GLOXIOU/Handbrake-DIY/BOM.csv

Component | Price
ESP-32 S3 | 8.93$
WH148 15mm 10K | 3.86$
Springs | 7.08$
Total | 19.87$
