GLOXIOU/Handbrake-DIY/3D-files/to print/Cover.stl

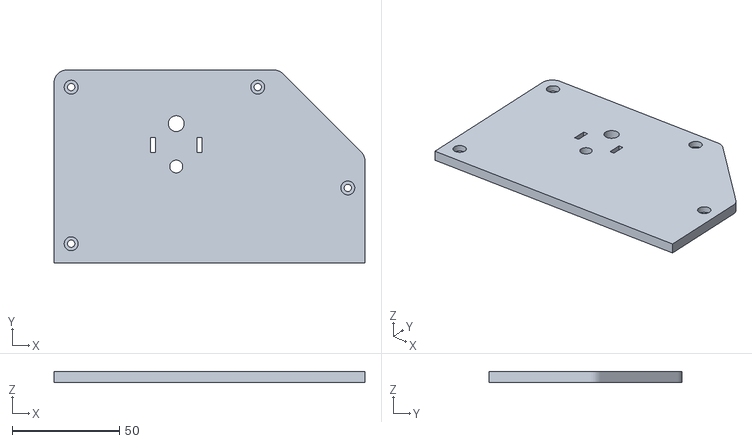
[picture p5: CAD file, 2026-10-22]
3D-files/to print/Cover.stl
145.0 x 90.0 x 5.00
