GLOXIOU/Handbrake-DIY/3D-files/to print/Lever.stl

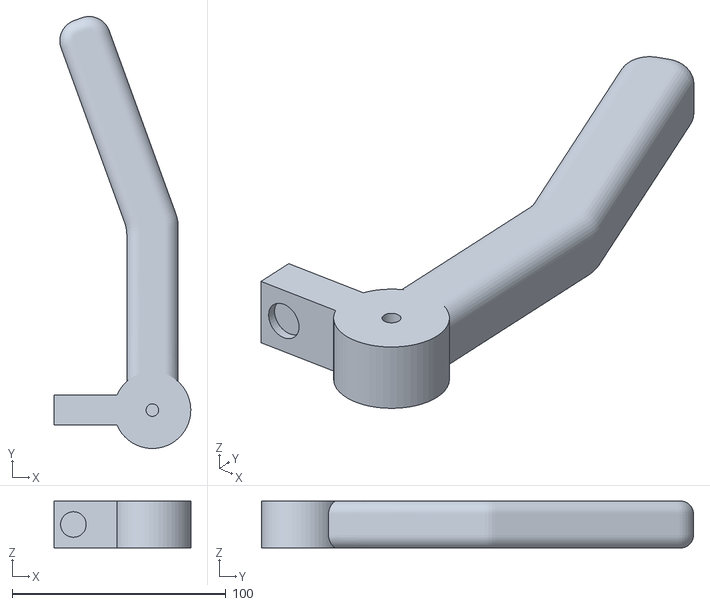
[picture p7: CAD file, 2026-10-22]
3D-files/to print/Lever.stl
64.0 x 202.3 x 22.0
