GLOXIOU/Handbrake-DIY/3D-files/to print/Case.stl

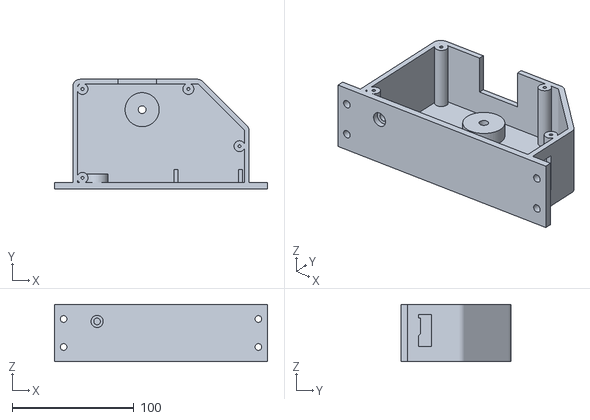
[picture p8: CAD file, 2026-10-22]
3D-files/to print/Case.stl
175.0 x 90.0 x 47.0
