GLOXIOU/Handbrake-DIY/3D-files/to print/PotCap.stl

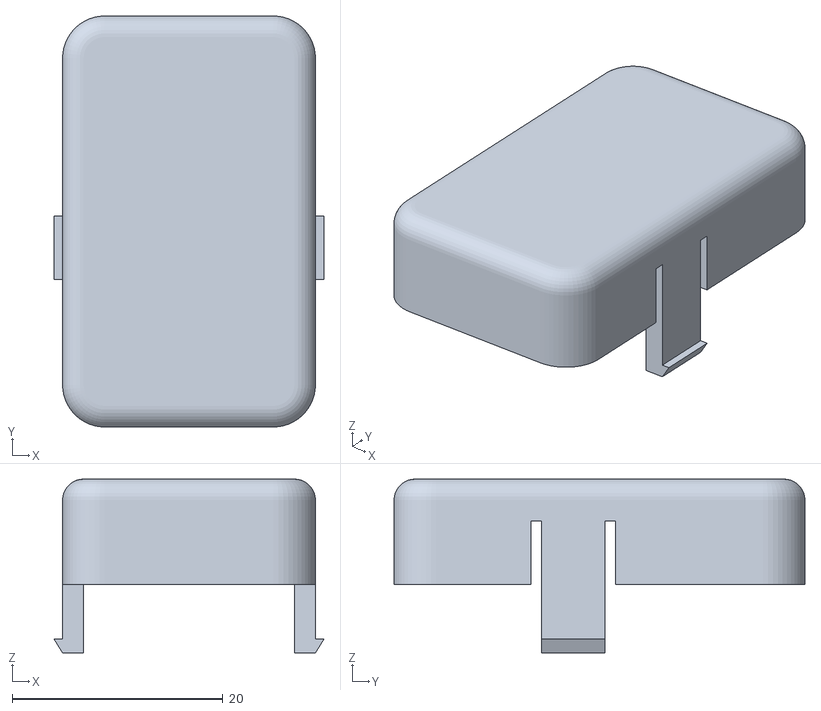
[picture p9: CAD file, 2026-10-22]
3D-files/to print/PotCap.stl
25.6 x 39.0 x 16.5
