GLOXIOU/Handbrake-DIY/(list of files, cad)

Other CAD files:
3D-files/Handbrake-DIY.f3d
