GLOXIOU/Handbrake-DIY/JOURNAL.md

| title | Handbrake-DIY |
| --- | --- |
| author | GLOXIOU |
| description | A DIY project for a simeracing handbrake, print in 3D and controlled by a ESP32.
| created_at | 2026-10-18 |

# Day 1: Defining system & idea search & inspiration

I want to make a simeracing handbrake, print in 3D, and controlled by a ESP32. The handbrake will have a litlle support so I can hang it up to my current support for my wheele. And the 3D part need to be bellow 256mm, because I will print it on a Bambulab A1.

My inspiration is the Laroal 64-bit USB Handbrake. I want to make that, but for much cheaper, and a litlle bit smaller. The only thing I want to keep from that housing is his shape.

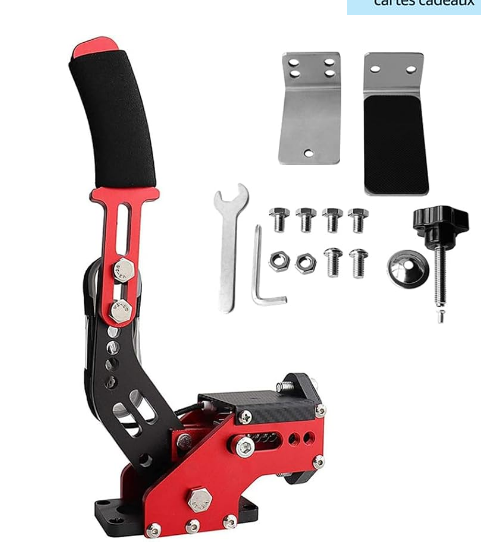
[picture p10: images/img-1.png]


So, here is an initial list of the equipment needed for the project which, of course, is still subject to change:

| Component | Price |
| --- | --- |
| [ESP-32 S3](https://fr.aliexpress.com/item/1005008809316571.html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) | 8.93$ |
| [WH148 15mm 10K](https://fr.aliexpress.com/item/1005006982762711.html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) | 3.86$ |
| [Springs](https://fr.aliexpress.com/item/1005003386795893.html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) | 7.08$ |
| Total | 19.87$ |

The spring is a compression springs, length 30mm, wire diameter 1.2mm, outer diameter 10mm.
To that, you need to have 1 screw M6×35 mm; 1 M6 lock nut (with nylon insert); 2 M6 washers; 1 M5 × 40 mm screw; 2 M5 nuts; 2 M5 washers. Don't buy it online, in a local store that will be much cheaper !

Now here's a litlle plan to see where is it going:

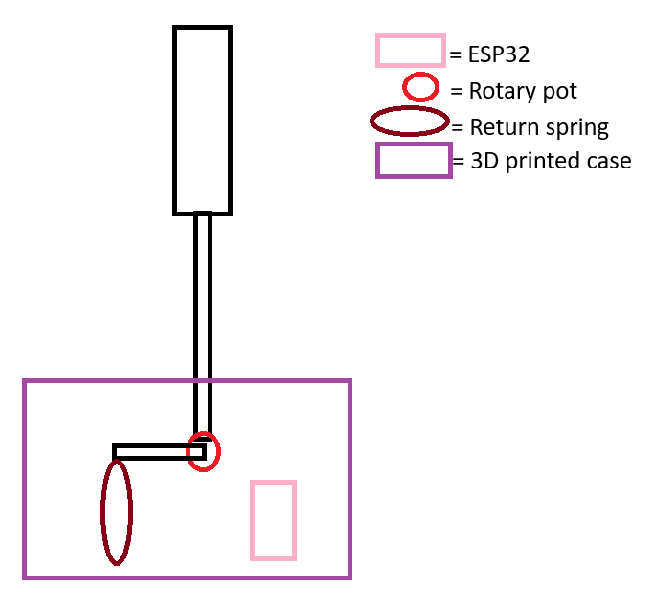
[picture p11: images/img-2.png]


**Total time spent: 2 hours**

# Day 2: 3D Modelling

Today, I'm in vacacion so I have a lot of time to make the case. So it's just need to be small, and usable, and easy.

So I created the folder for the 3D files, you can check it [just here](3D-files). After that, I lunched Fusion 360, and started modeling.

The first thing I made was the base of the case, where all the componments will be. It's 160x62mm.

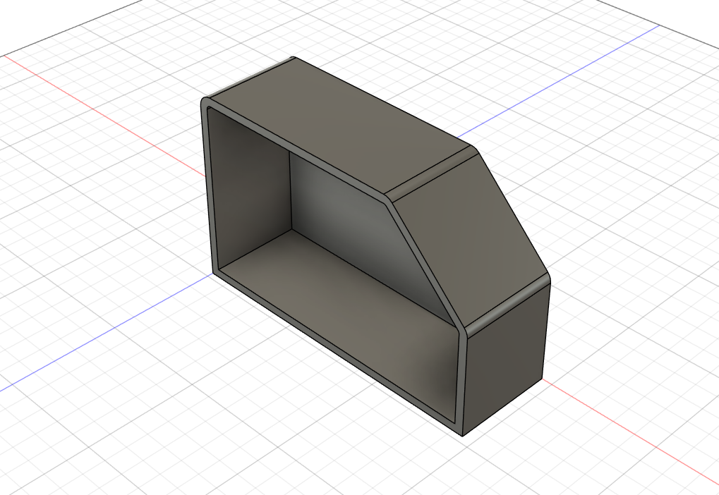
[picture p12: images/img-3.png]


Then, I made all the wholes and support for the screws, and others thinngs. I also added 2 litlle support thing on the two sides; So the height is changed.

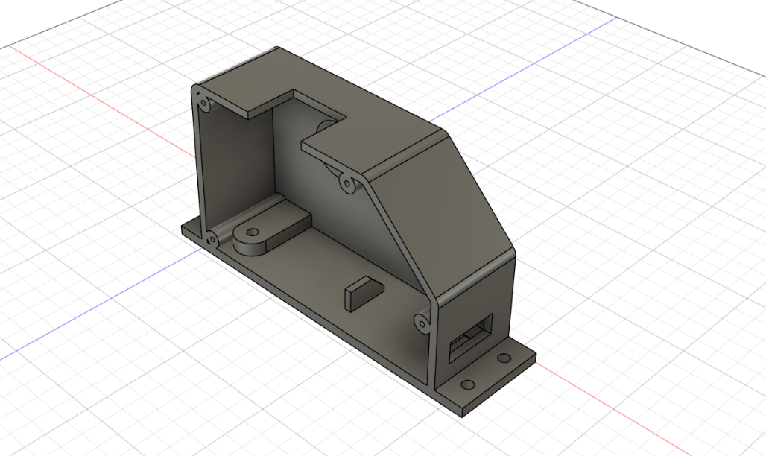
[picture p13: images/img-4.png]


Next I made the actual handbrake in one piece, with the whole for the potentiometer.

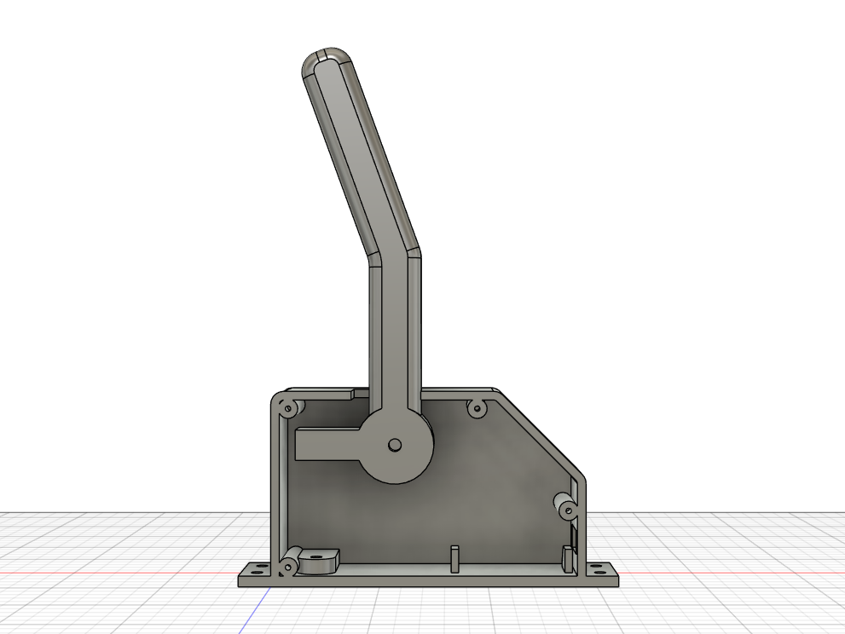
[picture p14: images/img-5.png]


After that, I made the side cover, with a litlle cover for the potentiometer and his cable that was exposed like on the first picture. There's also two wholes to clip the cover.

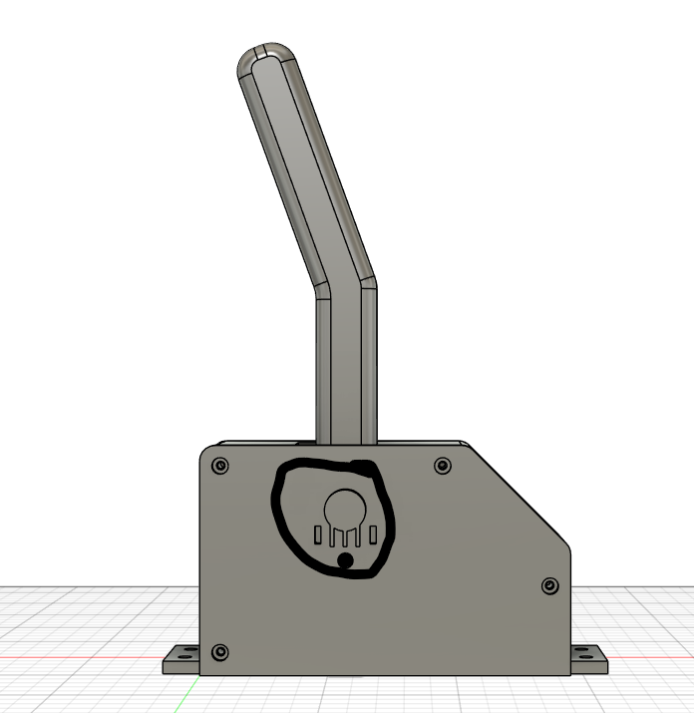
[picture p15: images/img-6.png]

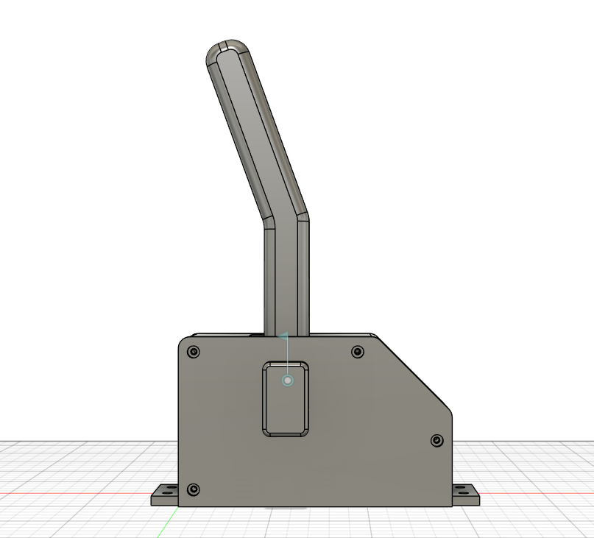
[picture p16: images/img-7.png]


And then, I made the assembly with the ESP, the screws, the potentiometer and the spring. So here's the final look of the model:



Position 1 - Normal position when the handbrake is not engaged:

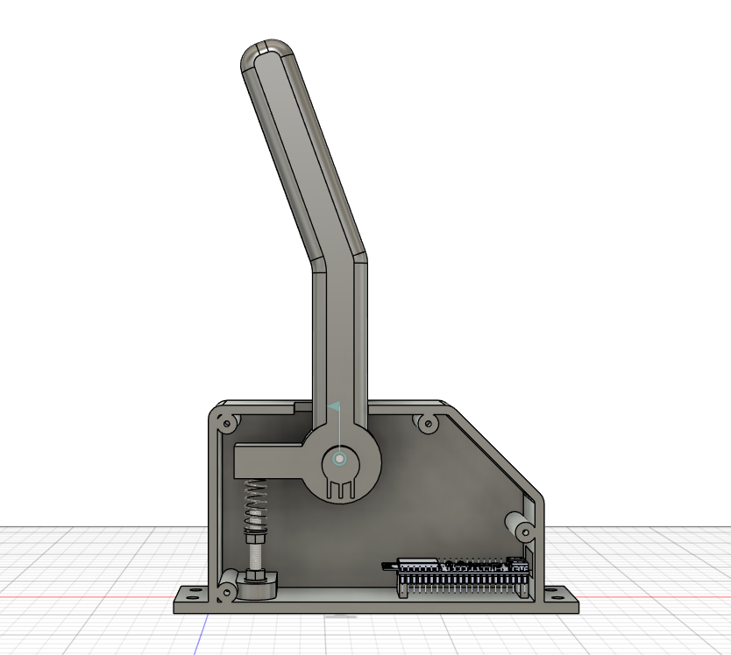
[picture p17: images/img-9.png]


Position 2 - Position when the handbrake is engaged:



So, all that’s left to do is the code and the README, which I plan to tackle tomorrow.

The case is 175mm by 249 by 62, and the support is adjustable kinda.

I know I didn’t write much in the log today, but I spent the whole day doing a lot of modeling. You can check the printable file [here](3D-files/to%20print/), and the step and assembly file [here](3D-files).

**Total time spent: 5 hours**

# Day 3: Firmware and README

Hey ! So today I just need to do the firmware, wich will not take a while, and after that I will be able to make the README.

SO I started by making a wiring diagram to make firmware development easier:



Then, I started the code. So, there’s nothing too complicated here, it includes features like calibration triggered by pressing the "boot" button with the values stored directly on the ESP. The program is also recognized by games as a game controller.

I was able to compile the code and test it on an ESP32 I had at home, using a potentiometer (which wasn't the right size, but served the purpose for testing), and it works perfectly !

The code really didn't take long to put together, nor was it complex—it only took about an hour to write and test everything...

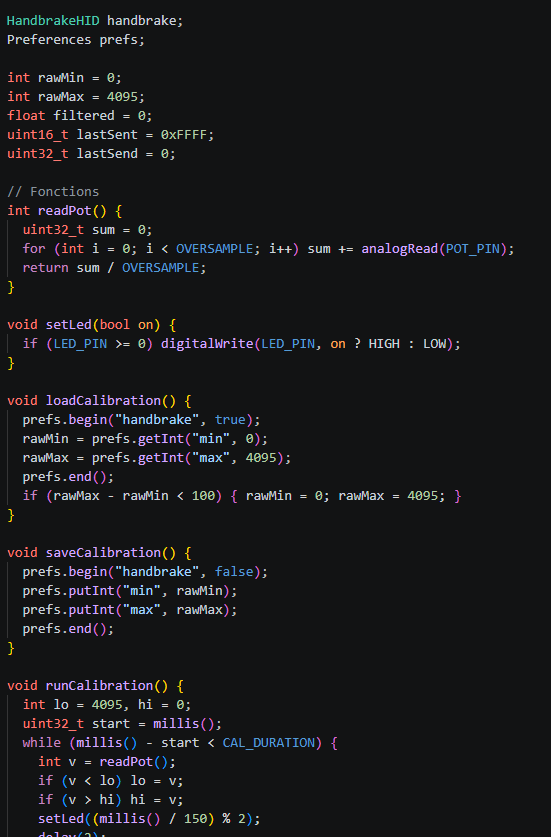
[picture p18: images/img-12.png]


Here's the [file](firmware.ino) for the firmware.

After that I made the README that you can check just [here](README.md).
And the [BOM](BOM.csv), just copy and paste the table I had already created in the journal.

And afetr a bit of a verification for all the project, it's finished ! The thing that taked the most of the time was the 3D modeling...

**Total time spent: 2.5 hours**
