GLOXIOU/Handbrake-DIY/(commit log)

2026-10-22 Day 2 - 3D modeling
    [Case.stl, Cover.stl, ESP32-S3-WROOM-1.STEP, Handbrake-DIY.f3d, Handbrake-DIY.step, Lever.stl, PotCap.stl]
2026-10-23 Day 3 - Finishing the project
    [BOM.csv]
2026-11-01 Add build guide and assembly instructions to README
